lucasbacle/hardware-smart-gas-detector/spice/conditioner_circuit.asc

C1: cap; 100n
C2: cap; 1µ
C3: cap; 100n
C4: cap; 100n
C5: cap; 1p
R1: res; 10k
R2: res; 100k
R3: res; 1k
R4: res; 100k
R5: res; 1k
U1: LTC2050HV
V1: voltage; 3.3
V2: voltage; SINE(0 325 50)
V3: voltage; PULSE(0 1 0.2 0.1 0.1 20)
X1: aime_gaz_sensor
Named nets: 0, vcc, in, out, parasite
.tran 4
;ac oct 200 0.1 0.1G
