lucasbacle/hardware-smart-gas-detector/hardware-smart-gaz-detector.kicad_pcb

## KiCad design hardware-smart-gaz-detector.kicad_pcb (2021-01-16)

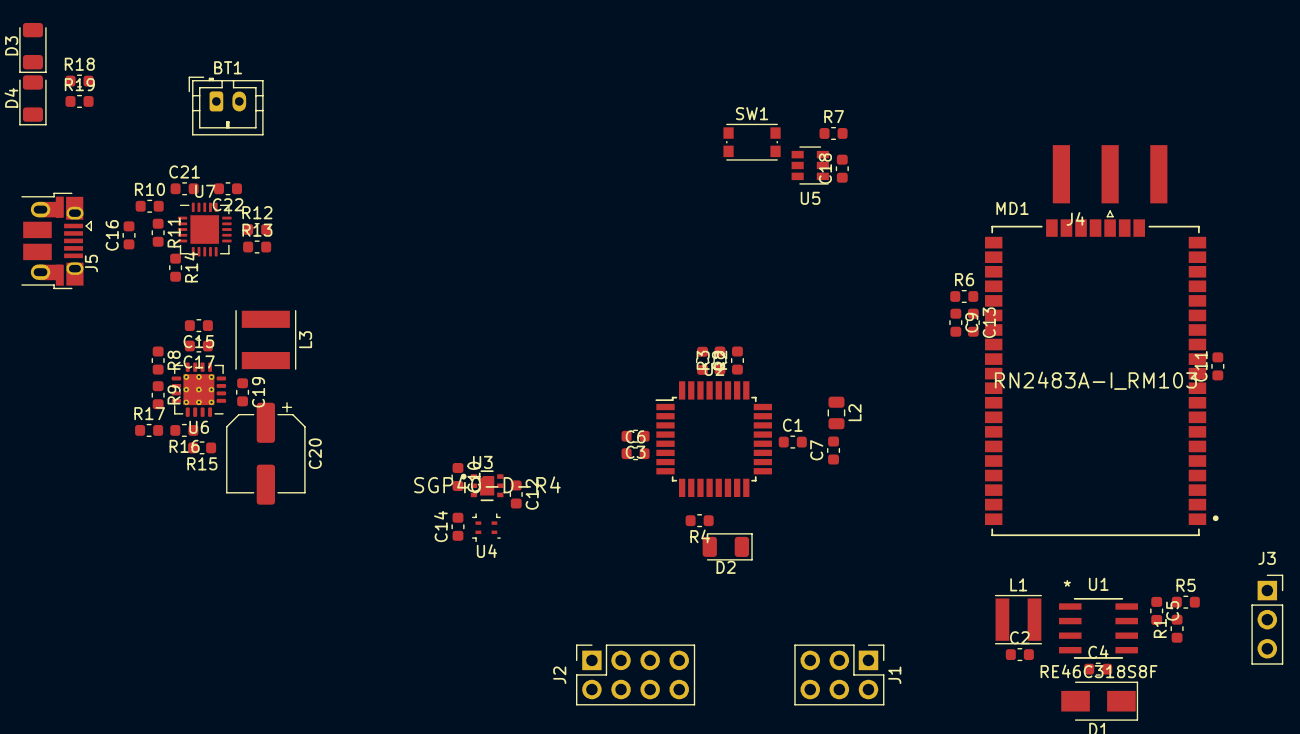
[picture p6: board hardware-smart-gaz-detector.kicad_pcb from above]

Board: 4 copper layers, 63 parts (0 on the bottom side), 44 nets, no tracks yet.

Parts:
BT1: 1c LiPo; JST_PH_B2B-PH-K_1x02_P2.00mm_Vertical
C1, C6, C7, C8, C11, C13, C14, C17, C18: 100n; C_0603_1608Metric
C2, C4, C15, C16, C21, C22: 10µ; C_0603_1608Metric
C3, C9: 4.7µ; C_0603_1608Metric
C5: 1n; C_0603_1608Metric
C10, C12: 1µ; C_0603_1608Metric
C19: 2.2µ; C_0603_1608Metric
C20: 100µ; CP_Elec_6.3x5.8
D1: D_Schottky; D_SMA
D2: LED; LED_1206_3216Metric
D3: ORANGE; LED_1206_3216Metric
D4: GREEN; LED_1206_3216Metric
J1: Conn_ICSP; PinHeader_2x03_P2.54mm_Vertical
J2: Conn_Extension; PinSocket_2x04_P2.54mm_Vertical
J3: Conn_Piezo; PinSocket_1x03_P2.54mm_Vertical
J4: SMA; SMA_Amphenol_132289_EdgeMount
J5: USB_B_Mini; USB_Micro-B_Amphenol_10103594-0001LF_Horizontal
L1: 10µ; L_Taiyo-Yuden_MD-4040
L2: 10µ; L_0805_2012Metric
L3: 6.8µ; L_Taiyo-Yuden_MD-5050
MD1: RN2483A-I_RM103; Microchip-RN2483A-I_RM103-0-0-MFG
R1: 1.5M; R_0603_1608Metric
R2, R3: 4.7k; R_0603_1608Metric
R4: 10; R_0603_1608Metric
R5, R16: 200k; R_0603_1608Metric
R6, R13: 100k; R_0603_1608Metric
R7: 22k; R_0603_1608Metric
R8: 1.87M; R_0603_1608Metric
R9: 340k; R_0603_1608Metric
R10: 330k; R_0603_1608Metric
R11: 110k; R_0603_1608Metric
R12, R18, R19: 1k; R_0603_1608Metric
R14: 15k; R_0603_1608Metric
R15: 1.1M; R_0603_1608Metric
R17: 1M; R_0603_1608Metric
SW1: SW_Push; SW_Push_1P1T_NO_CK_KMR2
U1: RE46C318S8F
U2: ATmega328P-AU; TQFP-32_7x7mm_P0.8mm
U3: SGP40-D-R4; Sensirion-SGP40-D-R4-MFG
U4: SHT4x; WDFN-4_1.5x1.5_Pitch0.8mm
U5: TPL5010; SOT-23-6
U6: TPS61090; Texas_S-PVQFN-N16_EP2.7x2.7mm_ThermalVias
U7: MCP73871-2AA; QFN-20-1EP_4x4mm_P0.5mm_EP2.5x2.5mm

Connections:
+3.3VA: C7.2, L2.2, U2.18
+3V3: C2.1, C3.1, C6.2, C9.2, C10.1, C11.2, C12.1, C13.2, C14.2, C18.1, C19.2, C20.1, J1.4, J2.1, L1.1, L2.1, MD1.12, MD1.34, R2.2, R3.2, R6.1, R15.1, R17.1, SW1.2, U1.2, U2.4, U2.6, U3.1, U3.5, U4.3, U5.1, U6.1, U6.15, U6.16
+10V: C4.2, D1.1, U1.5
+BATT: C15.2, C17.2, C21.2, L3.1, R8.1, U6.8, U6.11, U7.1, U7.20
ADC0: J2.7, U2.23
ADC1: J2.6, U2.24
GND: BT1.2, C1.2, C2.2, C3.2, C4.1, C6.1, C7.1, C8.1, C9.1, C10.2, C11.1, C12.2, C13.1, C14.1, C15.1, C16.1, C17.1, C18.2, C19.1, C20.2, C21.1, C22.1, D2.1, J1.6, J2.8, J4.2, J5.5, MD1.1, MD1.8, MD1.11, MD1.20, MD1.21, MD1.22, MD1.24, MD1.26, MD1.27, MD1.28, MD1.33, MD1.41, MD1.47, R7.2, R9.2, R11.2, R12.2, R13.2, R14.2, R16.2, U1.4, U2.3, U2.5, U2.21, U3.2, U3.4, U3.7, U4.4, U5.2, U6.5, U6.6, U6.7, U6.10, U6.13, U6.17, U7.10, U7.11, U7.21
GPIO_Done: U2.2, U5.4
GPIO_Horn: U1.8, U2.1
GPIO_LBO: R17.2, U2.32, U6.12
I2C_SCL: J2.2, R3.1, U2.28, U3.6, U4.2
I2C_SDA: J2.3, R2.1, U2.27, U3.3, U4.1
unnamed: BT1.1, C22.2, U7.14, U7.15, U7.16
unnamed: C1.1, U2.20
unnamed: C5.1, R1.2, R5.1, U1.1
unnamed: D1.2, L1.2, U1.3
unnamed: D2.2, R4.1
unnamed: D3.1, R18.1
unnamed: D4.1, R19.1
unnamed: J4.1, MD1.23
unnamed: L3.2, U6.3, U6.4
unnamed: R7.1, SW1.1, U5.3
unnamed: R8.2, R9.1, U6.9
unnamed: R10.2, R11.1, U7.2
unnamed: R12.1, U7.13
unnamed: R13.1, U7.12
unnamed: R14.1, U7.5
unnamed: R15.2, R16.1, U6.14
unnamed: R18.2, U7.8
unnamed: R19.2, U7.7
PCINT0_Wake: U2.12, U5.5
PWM0A_Led: R4.2, U2.10
PWM0B: J2.4, U2.9
RN2483_nRST: MD1.32, R6.2, U2.11
SPI_MISO: J1.1, U2.16
SPI_MOSI: J1.5, U2.15
SPI_SCK: J1.2, U2.17
UART0_RX: MD1.6, U2.30
UART0_TX: MD1.7, U2.31
VBUS: C16.2, D3.2, D4.2, J5.1, R10.1, U7.3, U7.4, U7.9, U7.17, U7.18, U7.19
nRST: C8.2, J1.3, U2.29, U5.6
piezo_feedback: J3.1, R5.2
piezo_gnd: J3.3, R1.1, U1.6
piezo_input: C5.2, J3.2, U1.7
