lucasbacle/hardware-smart-gas-detector/hardware-smart-gaz-detector-extension-board.kicad_pcb

## KiCad design hardware-smart-gaz-detector-extension-board.kicad_pcb (2021-01-16)

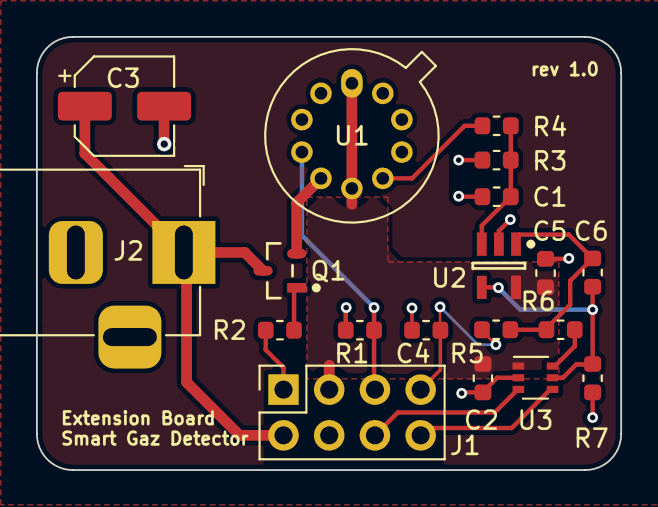
[picture p7: board hardware-smart-gaz-detector-extension-board.kicad_pcb from above]

Board: 2 copper layers, 32.5 x 24.1 mm, 19 parts (0 on the bottom side), 15 nets.

Parts:
C1, C2, C4, C5: 100n; C_0603_1608Metric
C3: 10µ; CP_Elec_5x5.4
C6: 1µ; C_0603_1608Metric
J1: Conn_Extension; PinSocket_2x04_P2.54mm_Vertical
J2: Jack-DC; BarrelJack_Horizontal
Q1: FDN327N; ON_Semi-527AG-01-12_2008-O-0
R1, R3: 10k; R_0603_1608Metric
R2: 250; R_0603_1608Metric
R4: 100k; R_0603_1608Metric
R5, R7: 1k; R_0603_1608Metric
R6: 50k; R_0603_1608Metric
U1: aime_gaz_sensor; TO-5-10_Window
U2: LTC2050HVCS5TRPBF; Linear_Technology-LTC2050HVCS5TRPBF-Level_B
U3: MCP4017-xxxxLT; SOT-363_SC-70-6

Connections:
+3V3: C2.2, C5.2, J1.3, U1.1, U1.6, U2.5, U3.1
+12V: C3.1, J1.2, J2.1, Q1.3
ADC0_Gaz: C4.2, J1.7, R5.2
ADC1_Temperature: J1.5, R1.2, U1.4
GND: C1.2, C2.1, C3.2, C4.1, C5.1, J1.4, J2.2, R1.1, R4.1, R7.1, U1.8, U1.9, U1.10, U2.2, U3.2
I2C_SCL: J1.6, U3.3
I2C_SDA: J1.8, U3.4
unnamed: C1.1, R3.1, R4.2, U2.3
unnamed: Q1.1, R2.2
unnamed: Q1.2, U1.5
unnamed: R6.2, U3.6
PWM_PolySi: J1.1, R2.1
aop_-: C6.1, R7.2, U2.4, U3.5
aop_out: C6.2, R5.1, R6.1, U2.1
u_gaz: R3.2, U1.7
