lucasbacle/hardware-smart-gas-detector/(commit log)

2020-11-23 add base kicad project
    [hardware-smart-gaz-detector.kicad_pcb, hardware-smart-gaz-detector.sch]
2020-11-24 update schematic
    [hardware-smart-gaz-detector.sch]
2020-12-02 version 0.2
    [hardware-smart-gaz-detector.sch]
2021-01-16 final commit before portfolio
    [hardware-smart-gaz-detector-extension-board.kicad_pcb, hardware-smart-gaz-detector-extension-board.sch, hardware-smart-gaz-detector.kicad_pcb]
2021-01-17 add aime gaz sensor datasheet
2021-01-17 update aime gaz sensor datasheet
